dev1adesh/8-bitComputer/8-Bit-Computer_sch.pdf

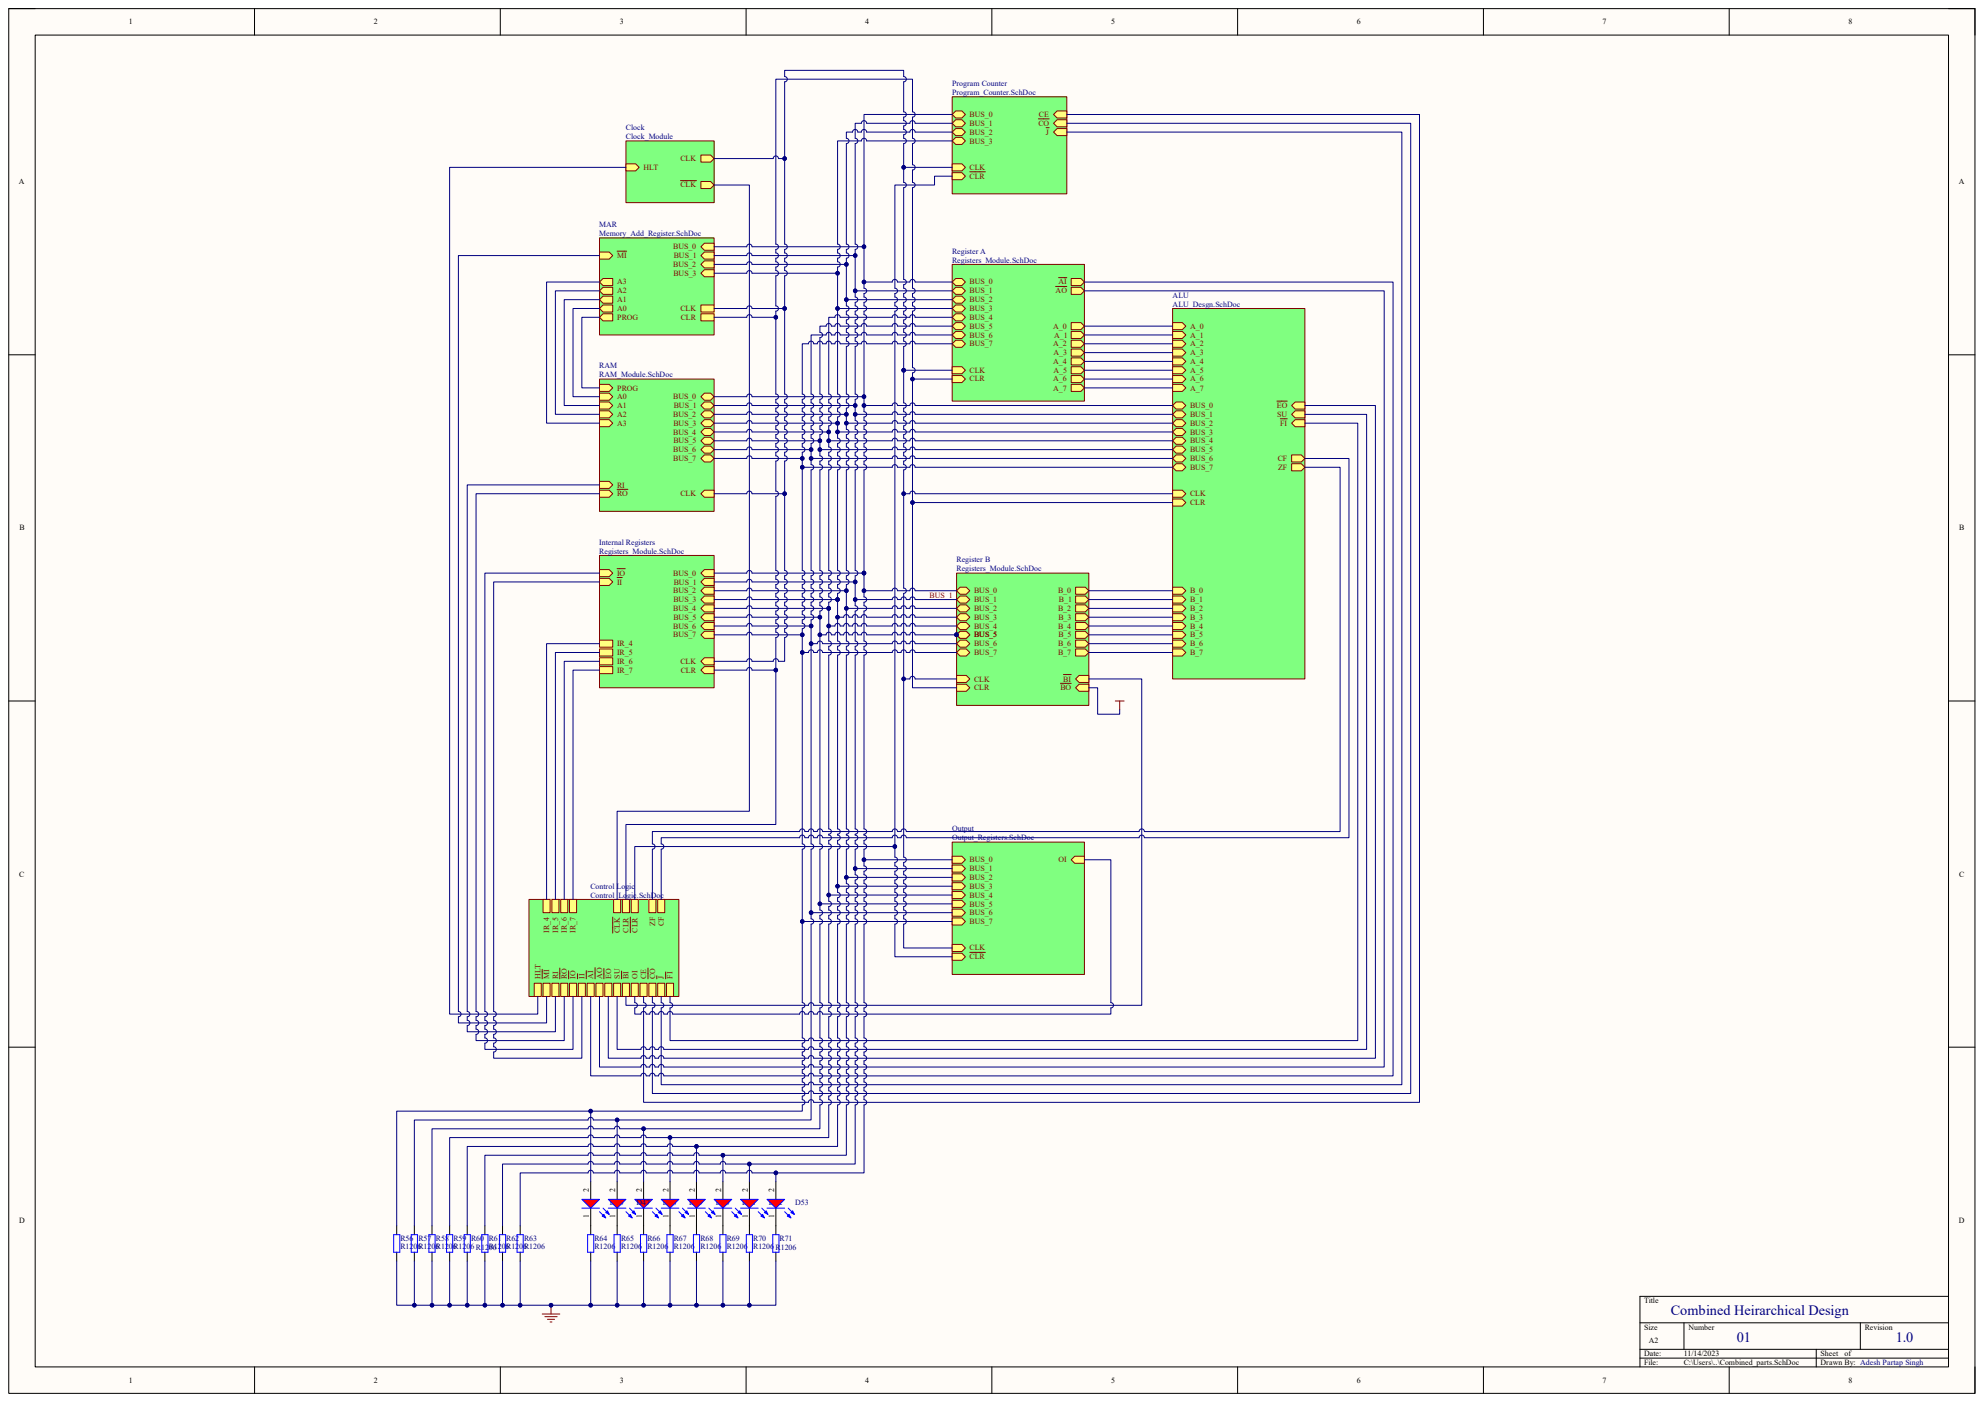
[picture p1: page 1]

Clock
Clock_Module
RAM_Module.SchDoc HLT MI RI ROIOIIAI AOEOSUBI OI CECO

JFI IR_4 IR_5 IR_6 IR_7 CLK CLR CLRZFCF

1

2

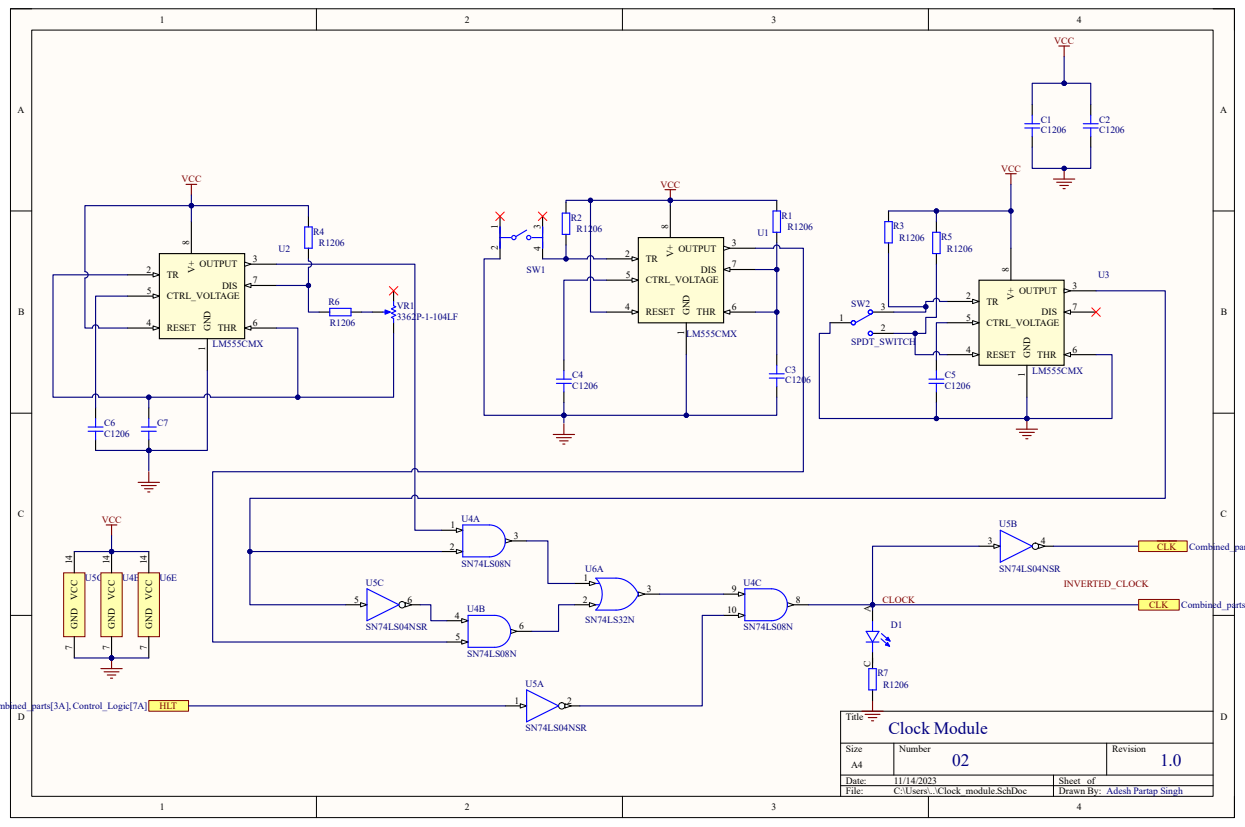
[picture p2: page 2]

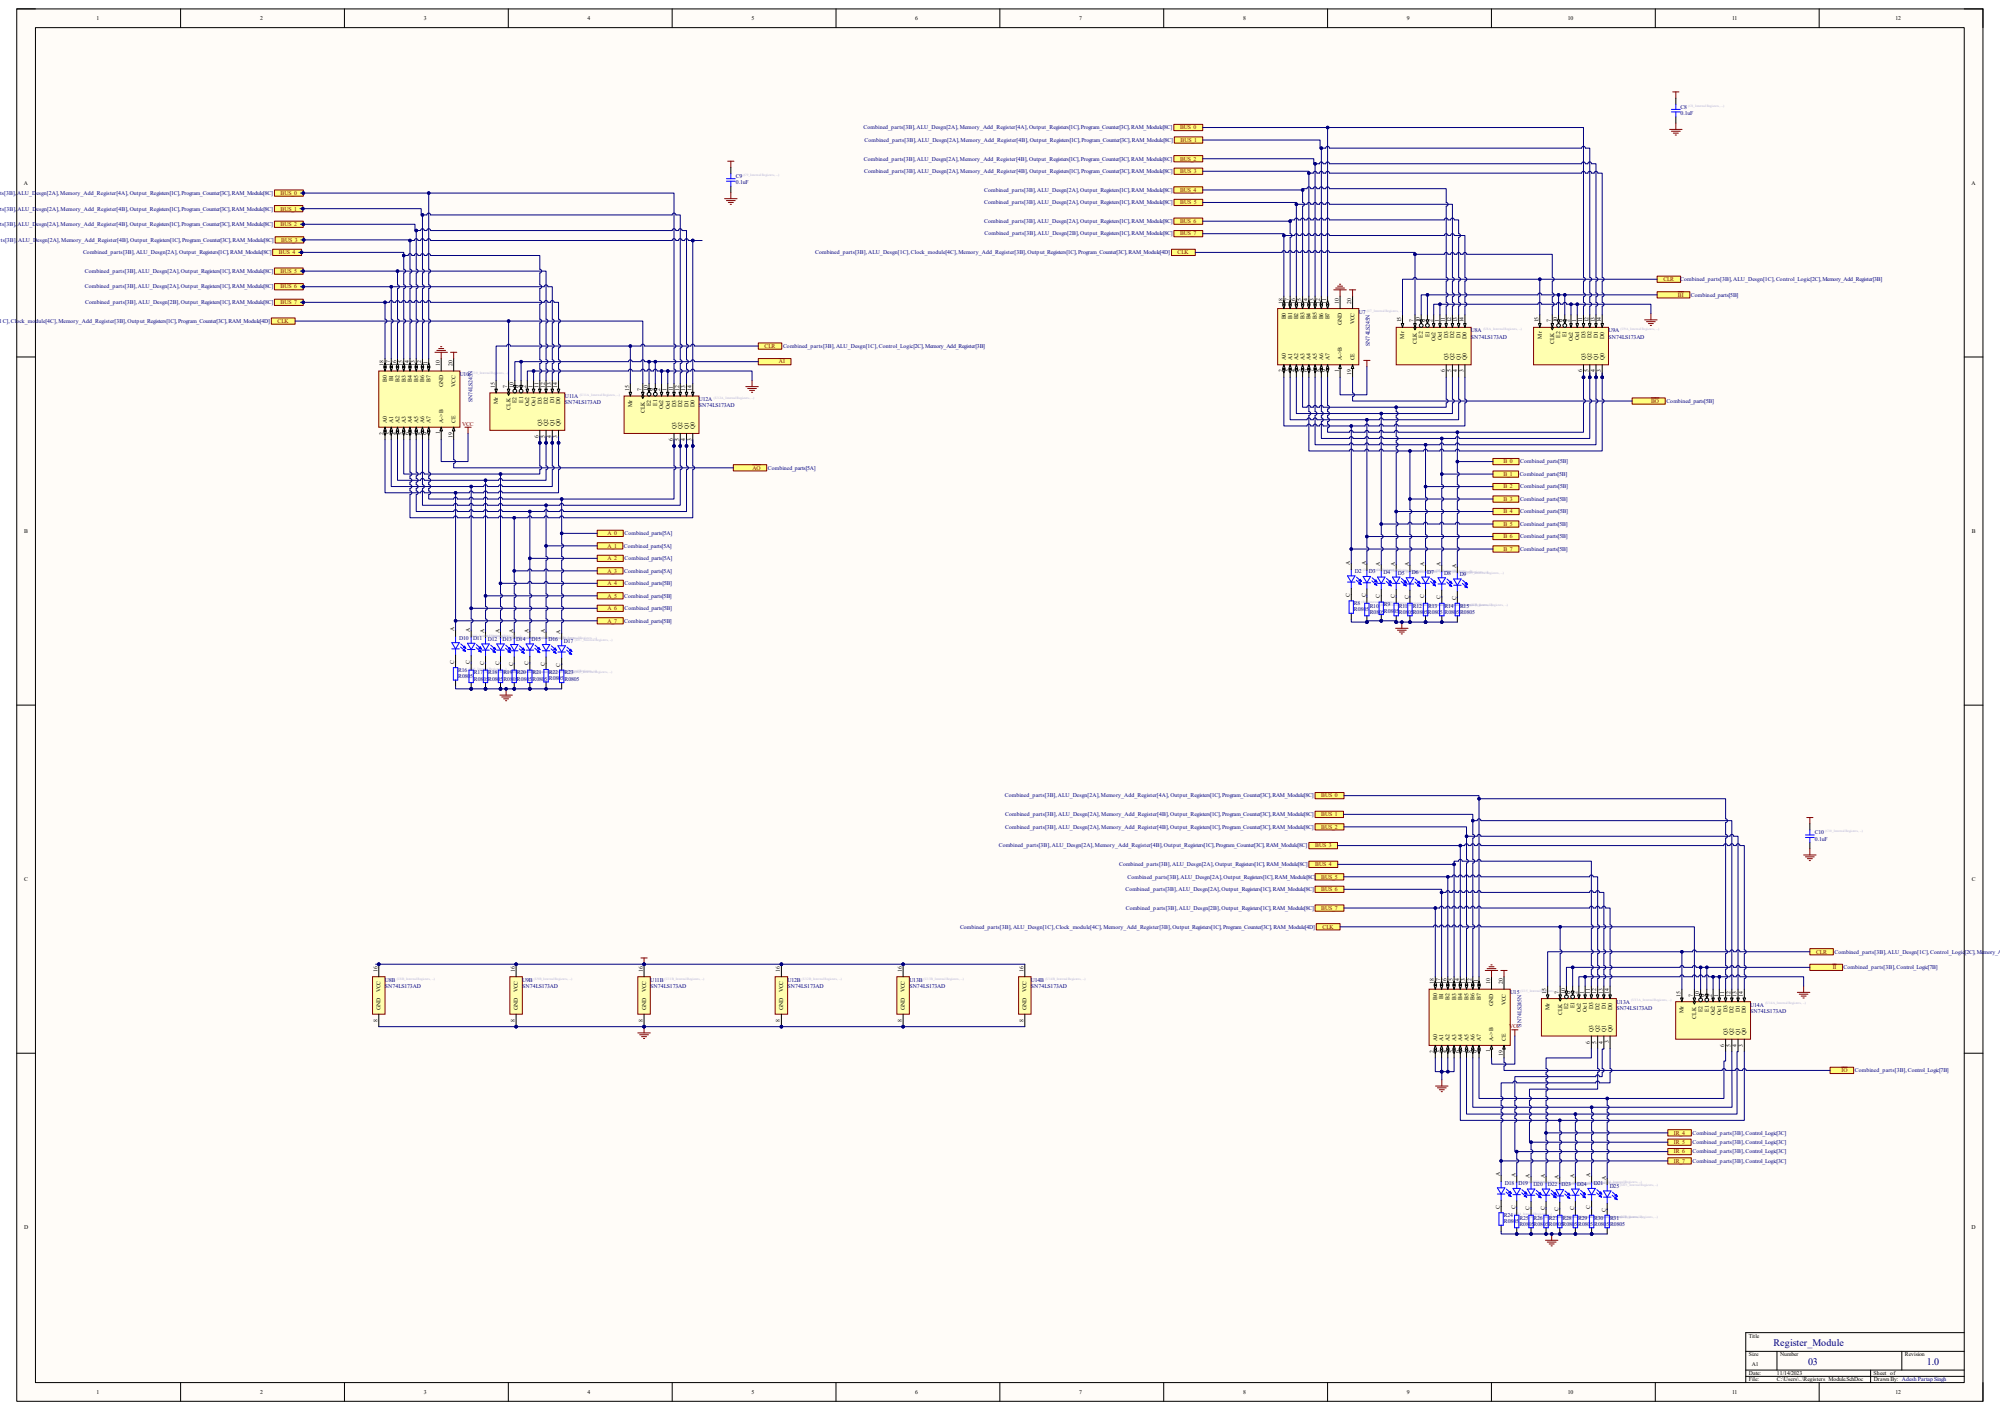
[picture p3: page 3]

BO Combined_parts[5B] A C
B_7 Combined_parts[5B] VCC ²⁰ CE 19 A⁰

VCC VCC ¹⁶ GND

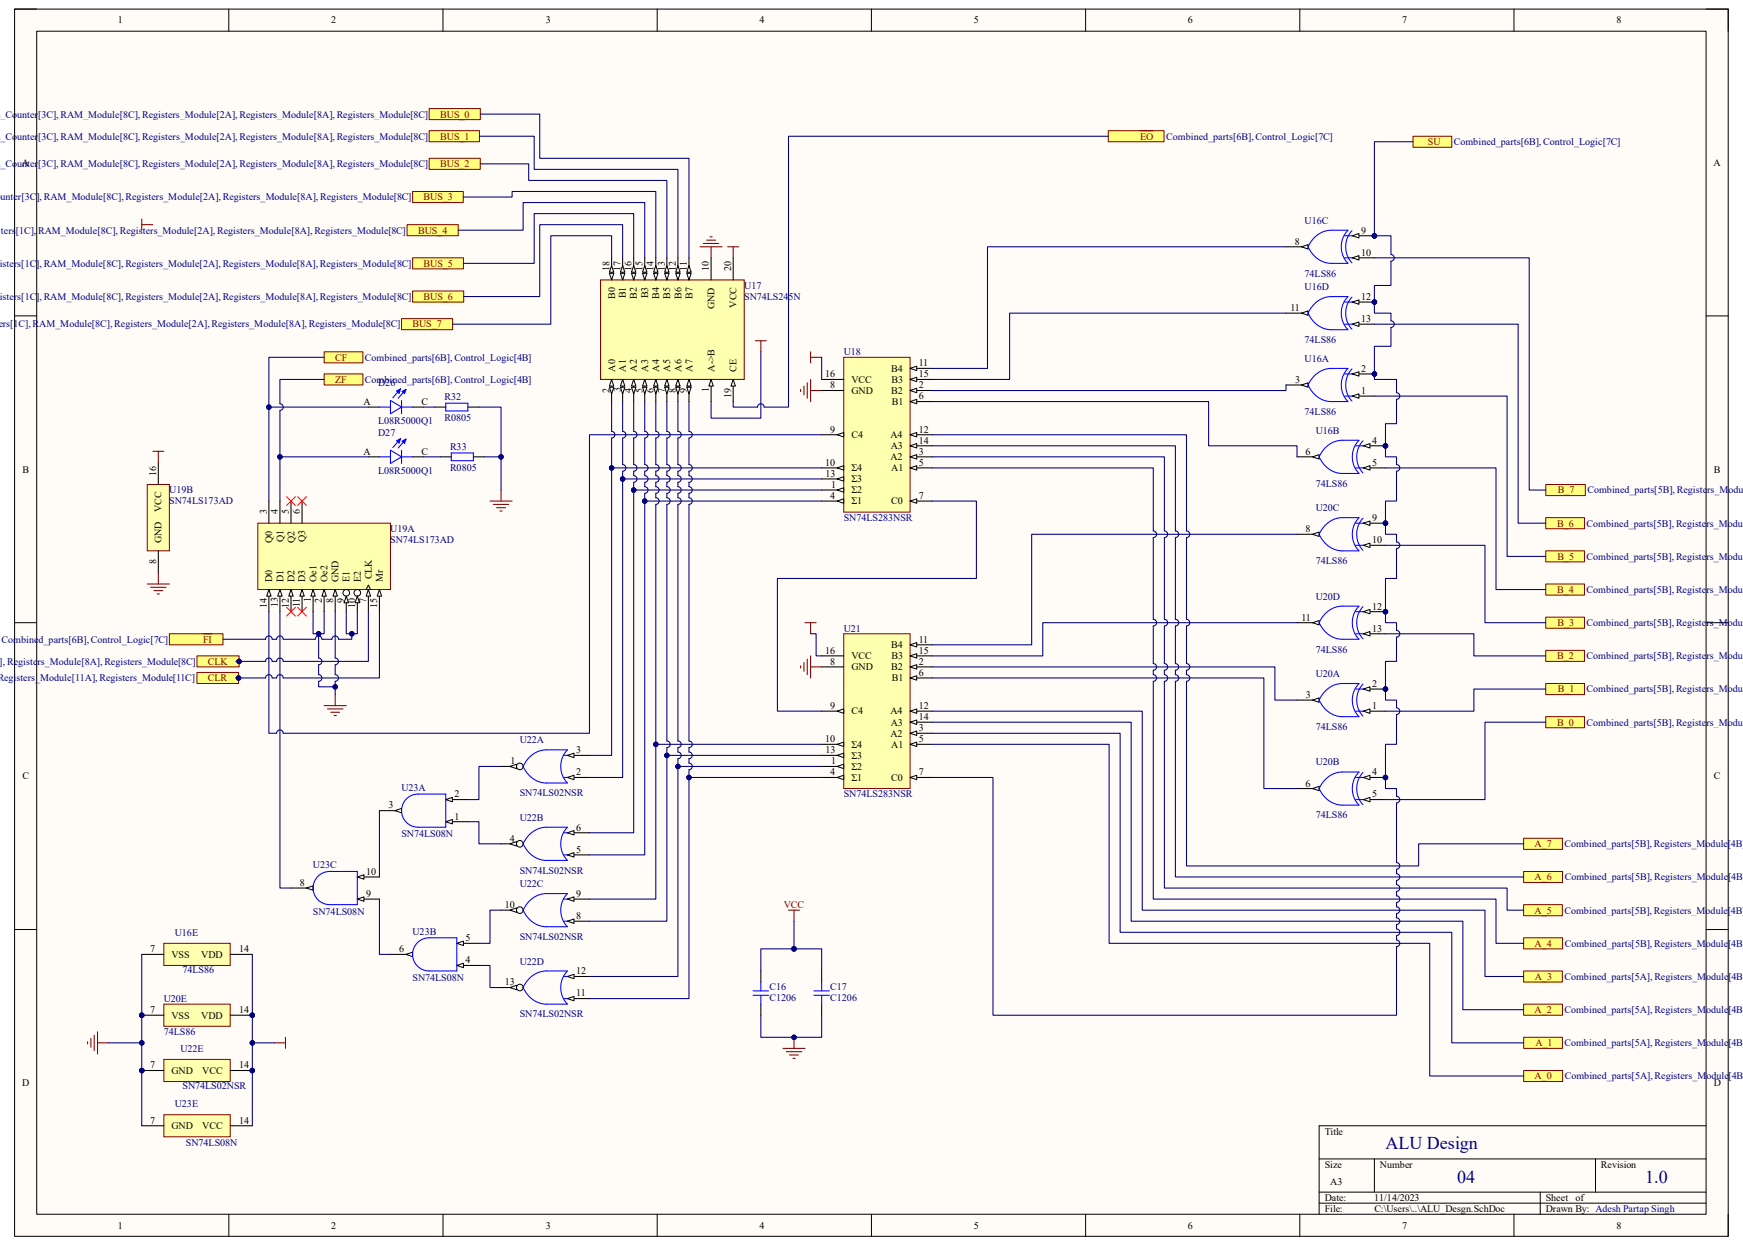
[picture p4: page 4]

SN74LS283NSR VCC ²⁰ CE 19 A⁰

A A

# D28 A C

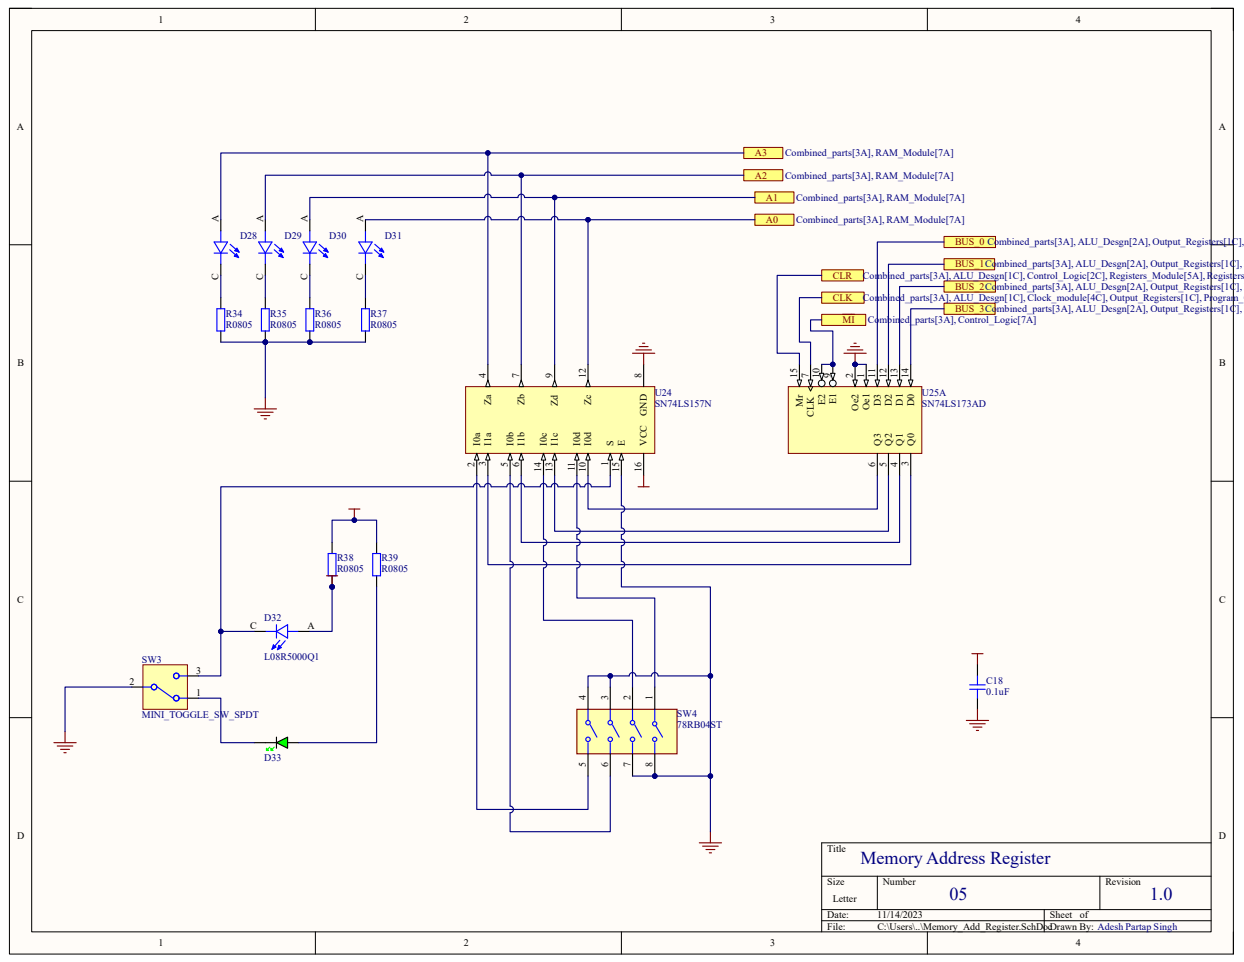
[picture p5: page 5]

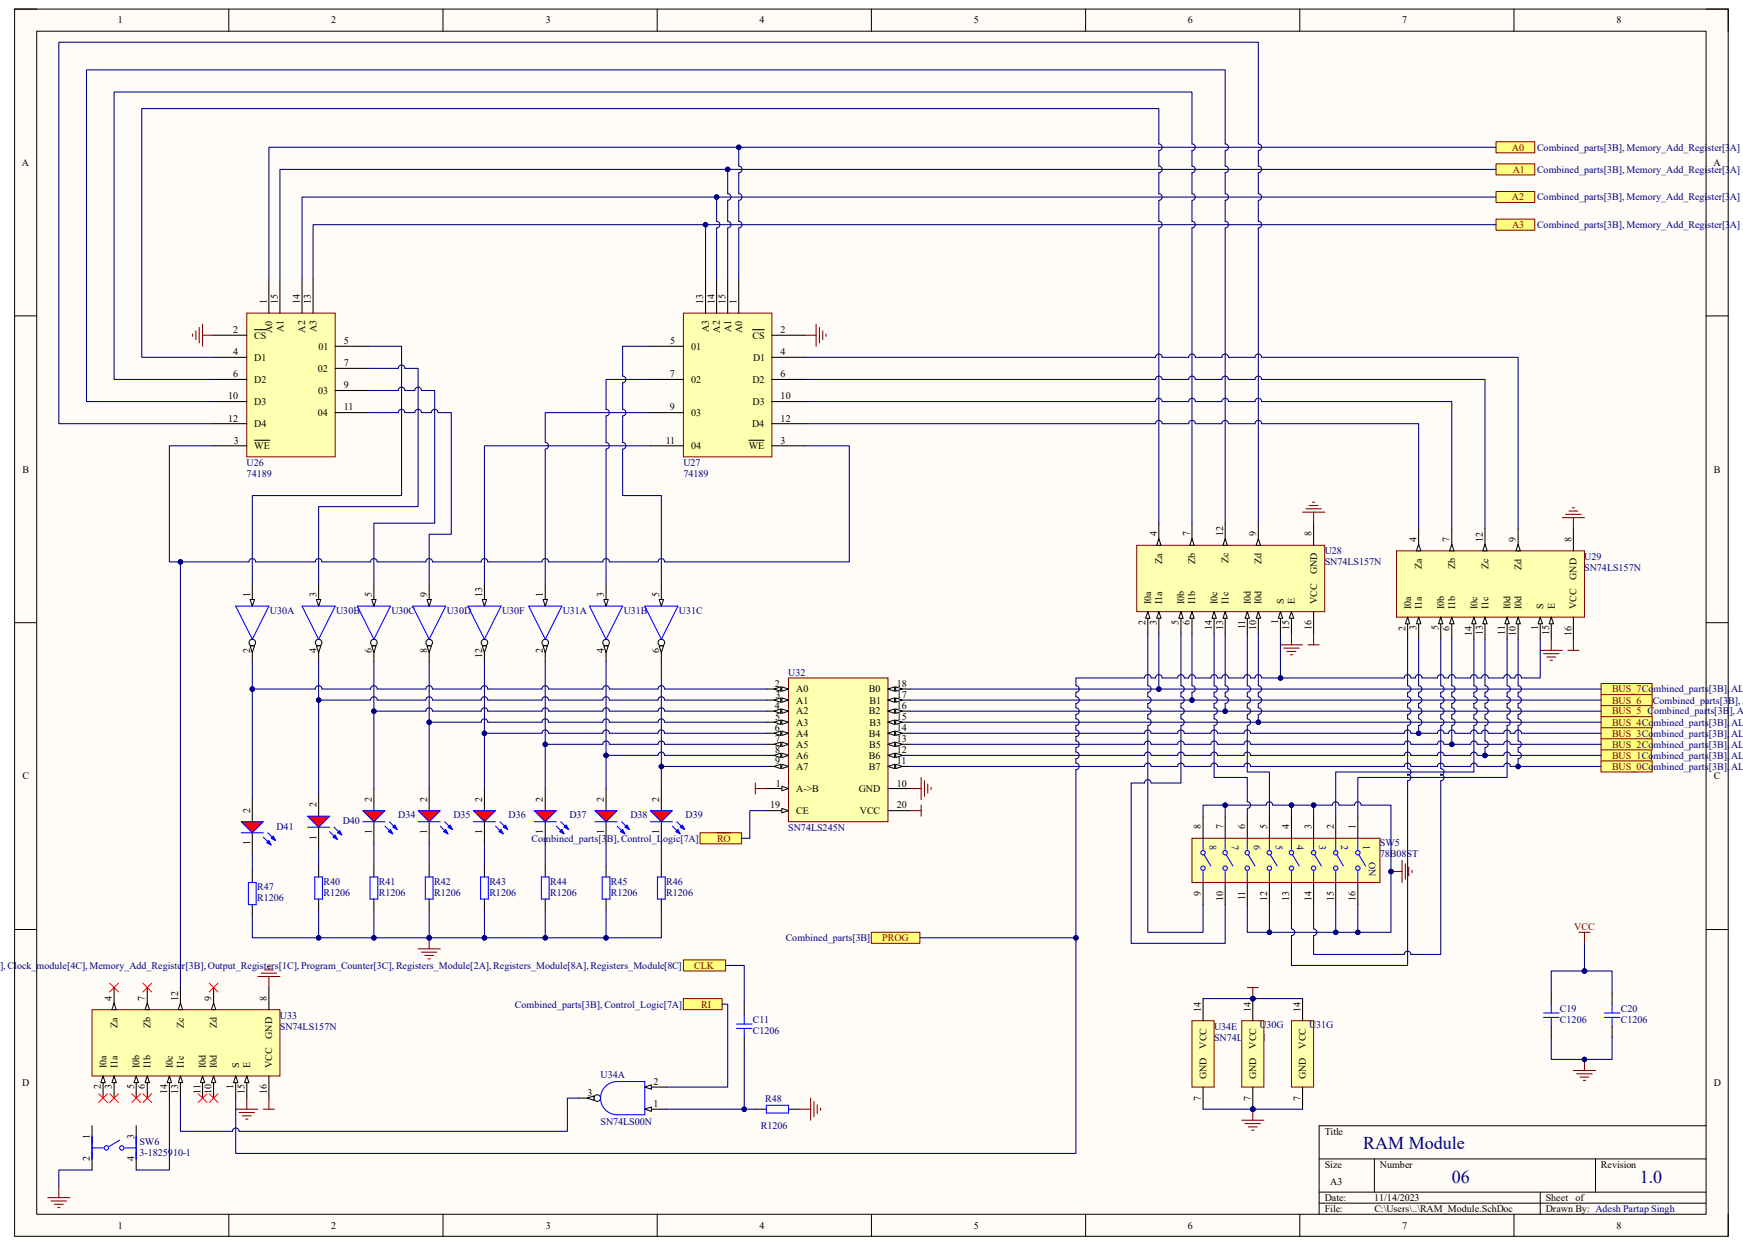
[picture p6: page 6]

A A

C21

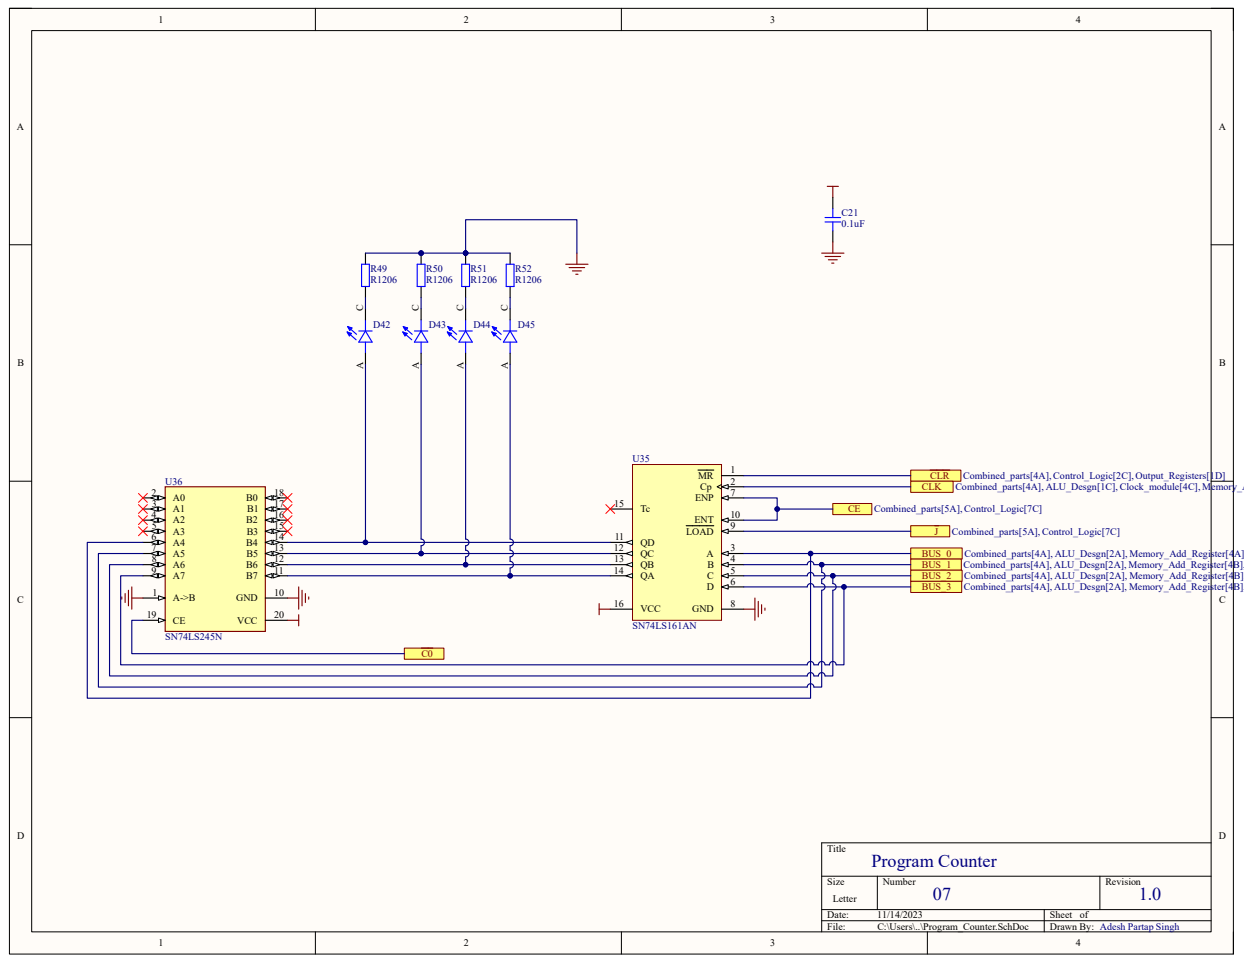
[picture p7: page 7]

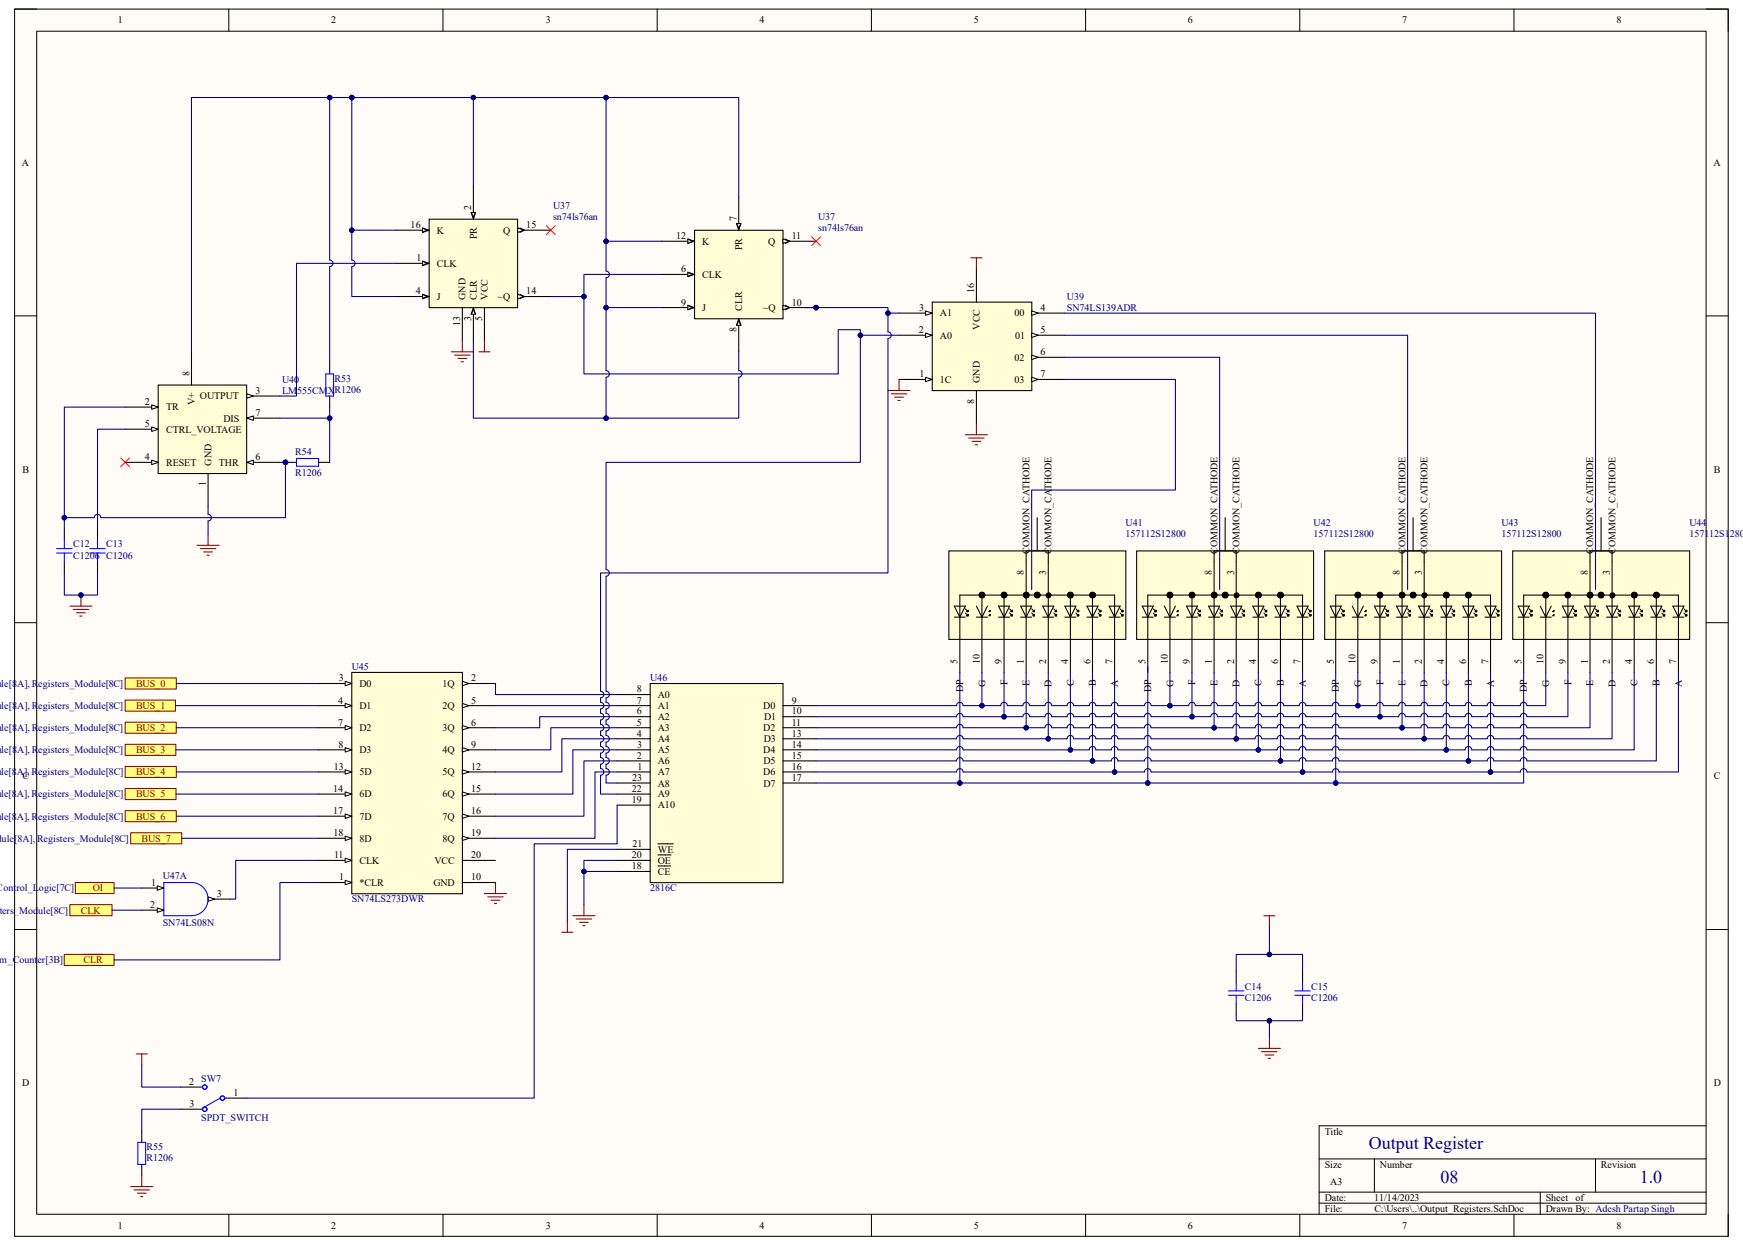
[picture p8: page 8]

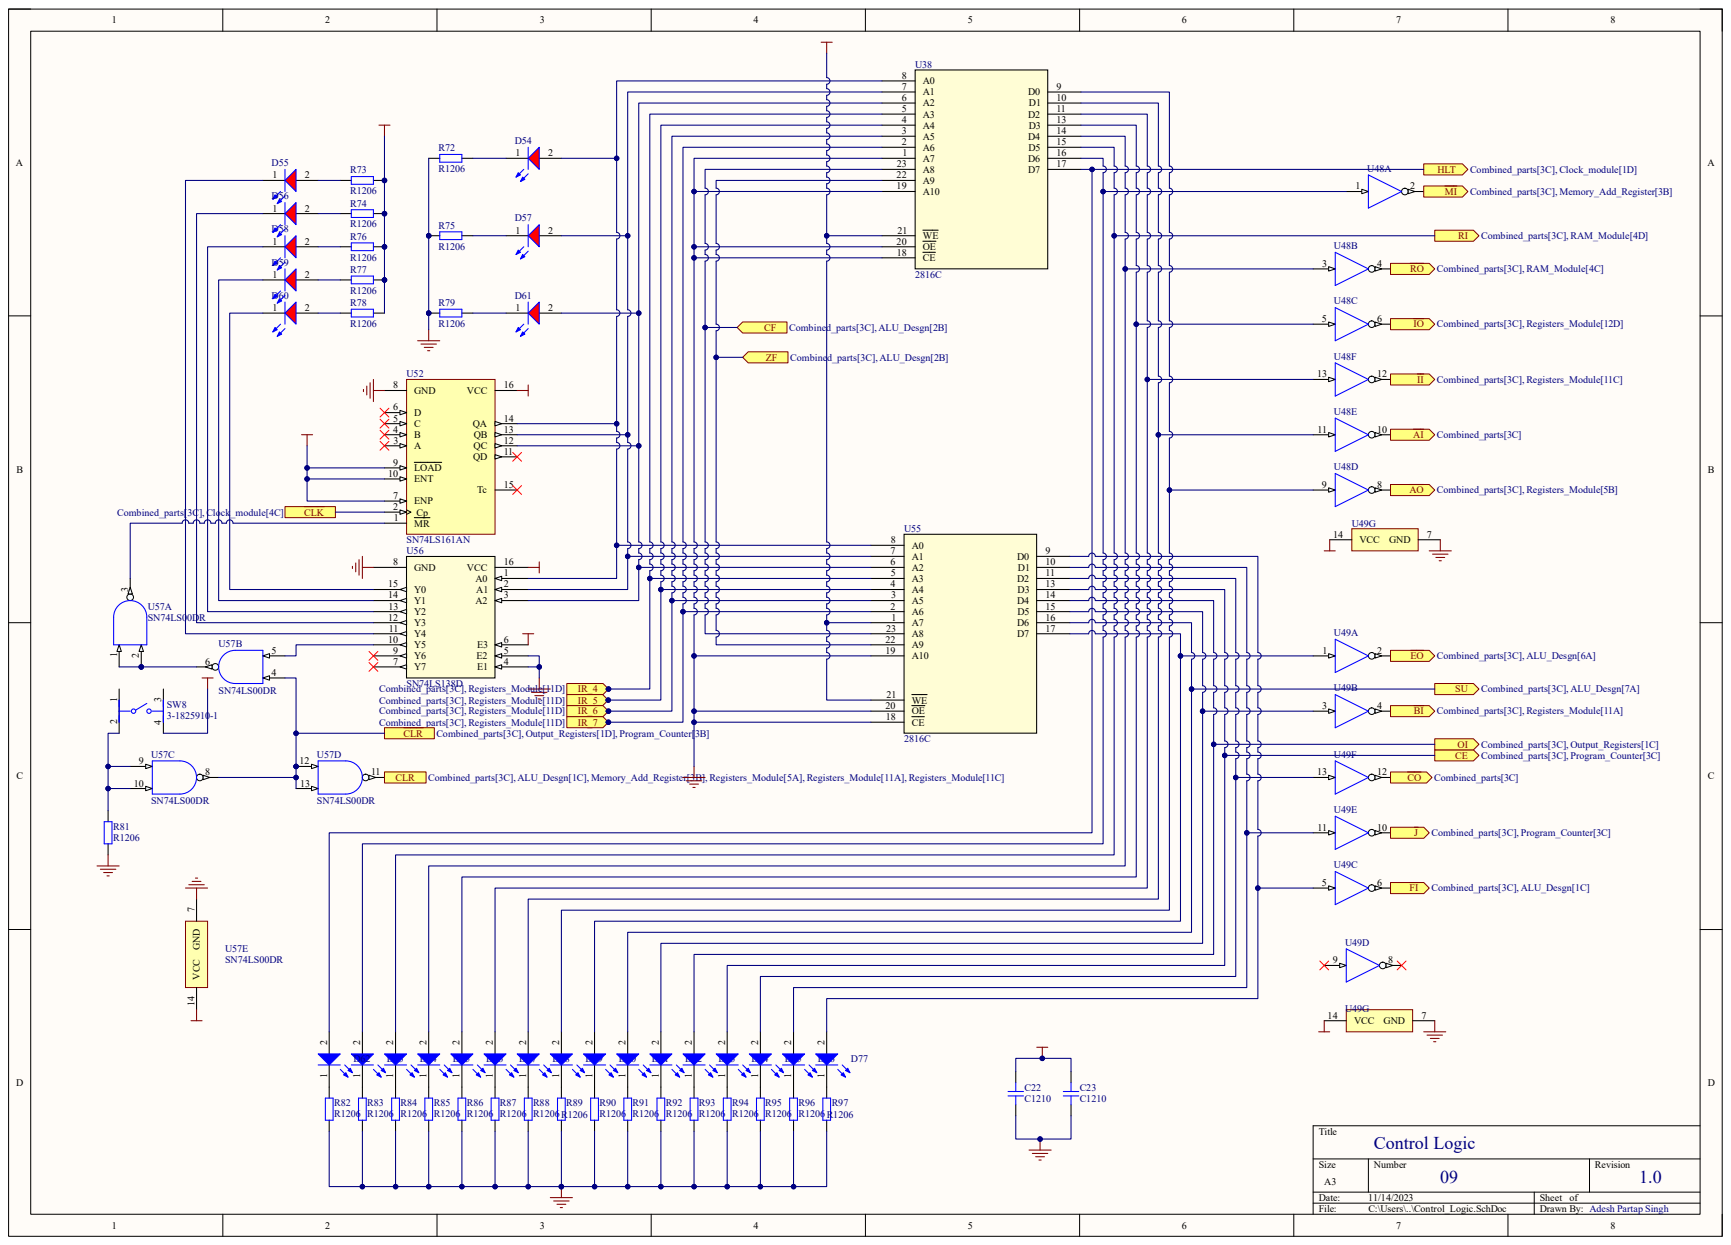
[picture p9: page 9]
