dev1adesh/8-bitComputer/(list of files, drawings)

Other design files:
ALU_Desgn.SchDoc
Clock_module.SchDoc
Combined_parts.SchDoc
Control_Logic.SchDoc
Memory_Add_Register.SchDoc
Output_Registers.SchDoc
Program_Counter.SchDoc
RAM_Module.SchDoc
Registers_Module.SchDoc
