dev1adesh/8-bitComputer/8bit-computer.kicad_pcb

## KiCad design 8bit-computer.kicad_pcb (2023-11-14)

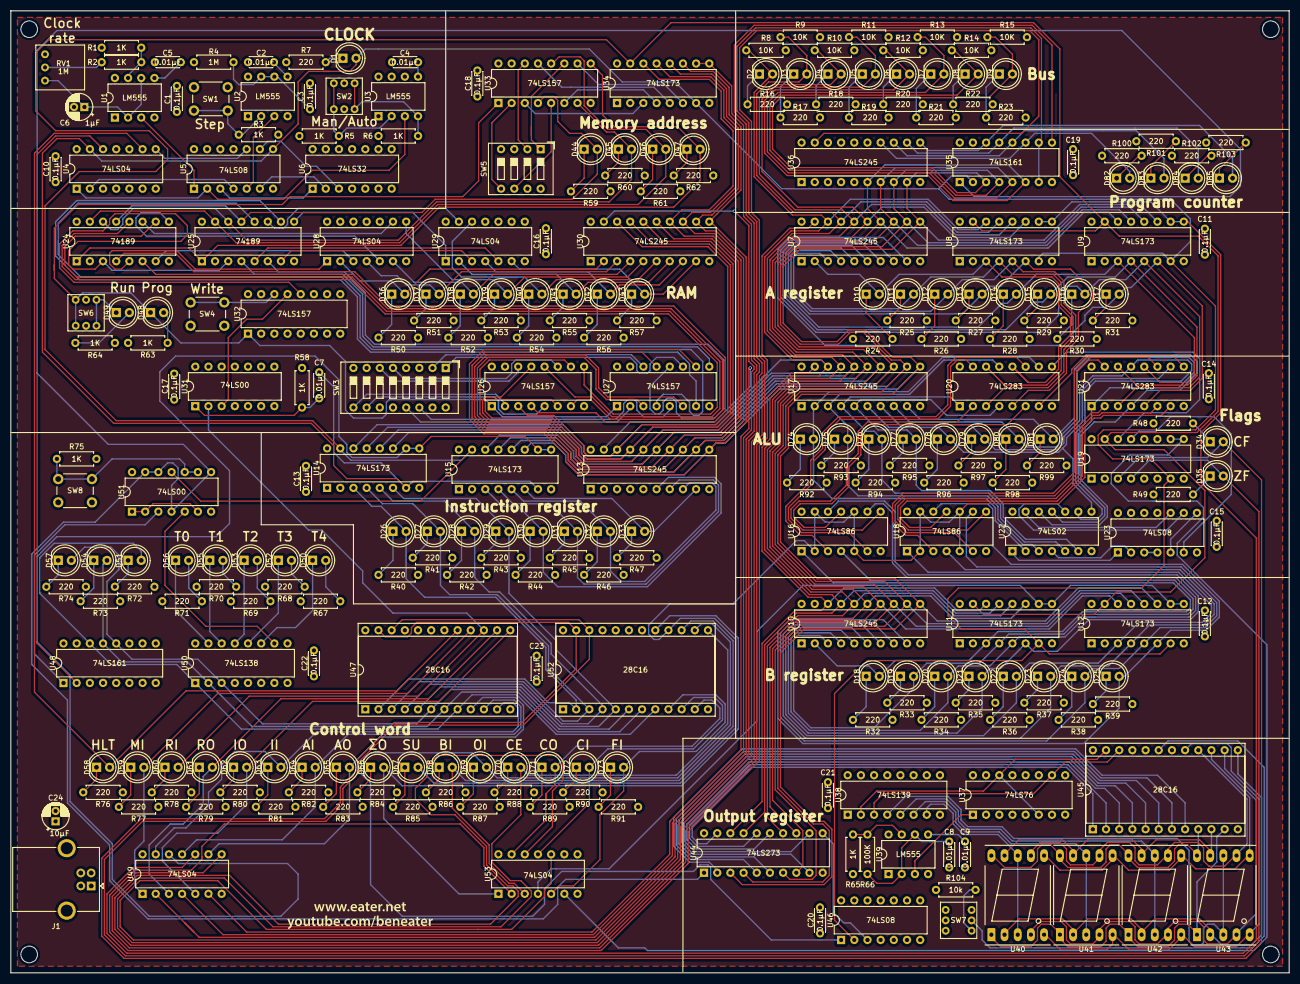
[picture p10: board 8bit-computer.kicad_pcb from above]

Board: 4 copper layers, 246.4 x 185.4 mm, 277 parts (0 on the bottom side), 290 nets.

Parts:
C1, C3, C10, C11, C12, C13, C14, C15, C16, C17, C18, C19, C20, C21, C22, C23: 0.1µF; C_Disc_D4.3mm_W1.9mm_P5.00mm
C2, C4, C5, C7, C8, C9: 0.01µF; C_Disc_D4.3mm_W1.9mm_P5.00mm
C6: 1µF; CP_Radial_D5.0mm_P2.00mm
C24: 10µF; CP_Radial_D5.0mm_P2.00mm
D1, D26, D27, D28, D29, D58, D59, D60, D61, D62, D63, D64, D65, D66, D67, D68, D69, D70, D71, D72, D73: BLUE; LED_D5.0mm
D2, D3, D4, D5, D6, D7, D8, D9, D10, D11, D12, D13, D14, D15, D16, D17, D18, D19, D20, D21, D22, D23, D24, D25, D36, D37, D38, D39, D40, D41, D42, D43, D48, D51, D54, D57, D74, D75, D76, D77, D78, D79, D80, D81: RED; LED_D5.0mm
D30, D31, D32, D33, D44, D45, D46, D47: YELLOW; LED_D5.0mm
D34, D35, D49, D50, D52, D53, D55, D56, D82, D83, D84, D85: GREEN; LED_D5.0mm
J1: USB_B; USB_B_OST_USB-B1HSxx_Horizontal
R1, R2, R3, R5, R6, R58, R63, R64, R65, R75: 1K; R_Axial_DIN0207_L6.3mm_D2.5mm_P7.62mm_Horizontal
R4: 1M; R_Axial_DIN0207_L6.3mm_D2.5mm_P7.62mm_Horizontal
R7, R16, R17, R18, R19, R20, R21, R22, R23, R24, R25, R26, R27, R28, R29, R30, R31, R32, R33, R34, R35, R36, R37, R38, R39, R40, R41, R42, R43, R44, R45, R46, R47, R48, R49, R50, R51, R52, R53, R54, R55, R56, R57, R59, R60, R61, R62, R67, R68, R69, R70, R71, R72, R73, R74, R76, R77, R78, R79, R80, R81, R82, R83, R84, R85, R86, R87, R88, R89, R90, R91, R92, R93, R94, R95, R96, R97, R98, R99, R100, R101, R102, R103: 220; R_Axial_DIN0207_L6.3mm_D2.5mm_P7.62mm_Horizontal
R8, R9, R10, R11, R12, R13, R14, R15: 10K; R_Axial_DIN0207_L6.3mm_D2.5mm_P7.62mm_Horizontal
R66: 100K; R_Axial_DIN0207_L6.3mm_D2.5mm_P7.62mm_Horizontal
R104: 10k; R_Axial_DIN0207_L6.3mm_D2.5mm_P7.62mm_Horizontal
RV1: 1M; Potentiometer-5.5mm
SW1, SW4: SW_Push; SW_PUSH_6mm_H5mm
SW2, SW6, SW7: SW_SPDT; DPDT-pushbutton
SW3: SW_DIP_x08; SW_DIP_SPSTx08_Slide_9.78x22.5mm_W7.62mm_P2.54mm
SW5: SW_DIP_x04; SW_DIP_SPSTx04_Slide_9.78x12.34mm_W7.62mm_P2.54mm
SW8: Reset; SW_PUSH_6mm_H5mm
U1, U2, U3, U39: LM555; DIP-8_W7.62mm
U4, U28, U29, U49, U53: 74LS04; DIP-14_W7.62mm
U5, U23, U46: 74LS08; DIP-14_W7.62mm
U6: 74LS32; DIP-14_W7.62mm
U7, U10, U13, U17, U30, U36: 74LS245; DIP-20_W7.62mm
U8, U9, U11, U12, U14, U15, U19, U34: 74LS173; DIP-16_W7.62mm
U16, U18: 74LS86; DIP-14_W7.62mm
U20, U21: 74LS283; DIP-16_W7.62mm
U22: 74LS02; DIP-14_W7.62mm
U24, U25: 74189; DIP-16_W7.62mm
U26, U27, U32, U33: 74LS157; DIP-16_W7.62mm
U31, U51: 74LS00; DIP-14_W7.62mm
U35, U48: 74LS161; DIP-16_W7.62mm
U37: 74LS76; DIP-16_W7.62mm
U38: 74LS139; DIP-16_W7.62mm
U40, U41, U42, U43: 7SEGMENT_CC; 7SegmentLED_LTS6760_LTS6780
U44: 74LS273; DIP-20_W7.62mm
U45, U47, U52: 28C16; DIP-24_W15.24mm_Socket
U50: 74LS138; DIP-16_W7.62mm
svg2mod: G***; BenEater

Connections:
/A register/A_0: D17.2, U7.9, U9.6, U21.5
/A register/A_1: D16.2, U7.8, U9.5, U21.3
/A register/A_2: D15.2, U7.7, U9.4, U21.14
/A register/A_3: D14.2, U7.6, U9.3, U21.12
/A register/A_4: D13.2, U7.5, U8.6, U20.5
/A register/A_5: D12.2, U7.4, U8.5, U20.3
/A register/A_6: D11.2, U7.3, U8.4, U20.14
/A register/A_7: D10.2, U7.2, U8.3, U20.12
/A register/BUS_0: D9.2, R15.1, U7.11, U9.11, U10.11, U12.11, U13.11, U15.11, U17.11, U27.10, U30.11, U34.11, U35.3, U36.9, U44.3
/A register/BUS_1: D8.2, R14.1, U7.12, U9.12, U10.12, U12.12, U13.12, U15.12, U17.12, U27.13, U30.12, U34.12, U35.4, U36.8, U44.4
/A register/BUS_2: D7.2, R13.1, U7.13, U9.13, U10.13, U12.13, U13.13, U15.13, U17.13, U27.6, U30.13, U34.13, U35.5, U36.7, U44.7
/A register/BUS_3: D6.2, R12.1, U7.14, U9.14, U10.14, U12.14, U13.14, U15.14, U17.14, U27.3, U30.14, U34.14, U35.6, U36.6, U44.8
/A register/BUS_4: D5.2, R11.1, U7.15, U8.11, U10.15, U11.11, U13.15, U14.11, U17.15, U26.10, U30.15, U44.13
/A register/BUS_5: D4.2, R10.1, U7.16, U8.12, U10.16, U11.12, U13.16, U14.12, U17.16, U26.13, U30.16, U44.14
/A register/BUS_6: D3.2, R9.1, U7.17, U8.13, U10.17, U11.13, U13.17, U14.13, U17.17, U26.6, U30.17, U44.17
/A register/BUS_7: D2.2, R8.1, U7.18, U8.14, U10.18, U11.14, U13.18, U14.14, U17.18, U26.3, U30.18, U44.18
/A register/CLK: C7.1, D1.2, U4.13, U5.8, U8.7, U9.7, U11.7, U12.7, U14.7, U15.7, U19.7, U34.7, U35.2, U46.2
/A register/CLR: U8.15, U9.15, U11.15, U12.15, U14.15, U15.15, U19.15, U34.15, U51.11
/A register/~AI: U8.9, U8.10, U9.9, U9.10, U49.10
/A register/~AO: U7.19, U49.8
/ALU/B_0: D25.2, U10.9, U12.6, U18.12
/ALU/B_1: D24.2, U10.8, U12.5, U18.9
/ALU/B_2: D23.2, U10.7, U12.4, U18.4
/ALU/B_3: D22.2, U10.6, U12.3, U18.1
/ALU/B_4: D21.2, U10.5, U11.6, U16.12
/ALU/B_5: D20.2, U10.4, U11.5, U16.9
/ALU/B_6: D19.2, U10.3, U11.4, U16.4
/ALU/B_7: D18.2, U10.2, U11.3, U16.1
/ALU/CF: D34.2, U19.3, U47.23, U52.23
/ALU/SU: D67.2, U16.2, U16.5, U16.10, U16.13, U18.2, U18.5, U18.10, U18.13, U21.7, U52.16
/ALU/ZF: D35.2, U19.4, U47.22, U52.22
/ALU/~EO: U17.19, U53.2
/ALU/~FI: U19.9, U19.10, U53.6
/B register/~BI: U11.9, U11.10, U12.9, U12.10, U53.4
/Clock/HLT: D58.2, U4.9, U47.17
/Clock/~CLK: U4.12, U48.2
/Control logic/CE: D70.2, U35.7, U35.10, U52.13
/Control logic/IR_4: D29.2, U14.6, U47.5, U52.5
/Control logic/IR_5: D28.2, U14.5, U47.4, U52.4
/Control logic/IR_6: D27.2, U14.4, U47.3, U52.3
/Control logic/IR_7: D26.2, U14.3, U47.2, U52.2
/Control logic/OI: D69.2, U46.1, U52.14
/Control logic/RI: D60.2, U31.2, U47.15
/Control logic/~CLR: U35.1, U44.1, U51.4, U51.8, U51.12, U51.13
/Control logic/~CO: U36.19, U53.12
/Control logic/~II: U14.9, U14.10, U15.9, U15.10, U49.12
/Control logic/~IO: U13.19, U49.6
/Control logic/~J: U35.9, U53.10
/Control logic/~MI: U34.9, U34.10, U49.2
/Control logic/~RO: U30.19, U49.4
/MAR/A0: D47.2, U24.1, U25.1, U33.9
/MAR/A1: D46.2, U24.15, U25.15, U33.12
/MAR/A2: D45.2, U24.14, U25.14, U33.7
/MAR/A3: D44.2, U24.13, U25.13, U33.4
/MAR/PROG: D48.1, SW6.1, U26.1, U27.1, U32.1, U33.1
GND: C1.2, C2.2, C3.2, C4.2, C5.2, C6.2, C8.2, C9.2, C10.2, C11.2, C12.2, C13.2, C14.2, C15.2, C16.2, C17.2, C18.2, C19.2, C20.2, C21.2, C22.2, C23.2, C24.2, J1.4, J1.5, R7.2, R8.2, R9.2, R10.2, R11.2, R12.2, R13.2, R14.2, R15.2, R16.2, R17.2, R18.2, R19.2, R20.2, R21.2, R22.2, R23.2, R24.2, R25.2, R26.2, R27.2, R28.2, R29.2, R30.2, R31.2, R32.2, R33.2, R34.2, R35.2, R36.2, R37.2, R38.2, R39.2, R40.2, R41.2, R42.2, R43.2, R44.2, R45.2, R46.2, R47.2, R48.1, R49.1, R50.2, R51.2, R52.2, R53.2, R54.2, R55.2, R56.2, R57.2, R58.1, R59.2, R60.2, R61.2, R62.2, R72.2, R73.2, R74.2, R75.2, R76.2, R77.2, R78.2, R79.2, R80.2, R81.2, R82.2, R83.2, R84.2, R85.2, R86.2, R87.2, R88.2, R89.2, R90.2, R91.2, R92.2, R93.2, R94.2, R95.2, R96.2, R97.2, R98.2, R99.2, R100.1, R101.1, R102.1, R103.1, R104.2, SW1.1, SW2.2, SW3.3, SW3.4, SW3.7, SW3.8, SW3.11, SW3.12, SW3.15, SW3.16, SW4.1, SW5.3, SW5.4, SW5.7, SW5.8, SW6.2, U1.1, U2.1, U3.1, U3.6, U4.7, U5.7, U6.7, U7.10, U8.1, U8.2, U8.8, U9.1, U9.2, U9.8, U10.10, U11.1, U11.2, U11.8, U12.1, U12.2, U12.8, U13.2, U13.3, U13.4, U13.5, U13.10, U14.1, U14.2, U14.8, U15.1, U15.2, U15.8, U16.7, U17.10, U18.7, U19.1, U19.2, U19.8, U20.8, U21.8, U22.7, U23.7, U24.2, U24.8, U25.2, U25.8, U26.8, U26.15, U27.8, U27.15, U28.7, U29.7, U30.10, U31.7, U32.8, U32.15, U33.8, U33.15, U34.1, U34.2, U34.8, U35.8, U36.1, U36.10, U37.13, U38.1, U38.8, U39.1, U44.10, U45.12, U45.18, U45.20, U46.7, U47.1, U47.12, U47.18, U47.19, U47.20, U48.8, U49.7, U50.4, U50.5, U50.8, U51.7, U52.12, U52.18, U52.19, U52.20, U53.7
unnamed: C2.1, U2.5
unnamed: C3.1, R4.2, U2.6, U2.7
unnamed: C4.1, U3.5
unnamed: C5.1, U1.5
unnamed: C6.1, RV1.1, U1.2, U1.6
unnamed: C7.2, R58.2, U31.1
unnamed: C8.1, R66.2, U39.2, U39.6
unnamed: C9.1, U39.5
unnamed: D1.1, R7.1
unnamed: D2.1, R16.1
unnamed: D3.1, R17.1
unnamed: D4.1, R18.1
unnamed: D5.1, R19.1
unnamed: D6.1, R20.1
unnamed: D7.1, R21.1
unnamed: D8.1, R22.1
unnamed: D9.1, R23.1
unnamed: D10.1, R24.1
unnamed: D11.1, R25.1
unnamed: D12.1, R26.1
unnamed: D13.1, R27.1
unnamed: D14.1, R28.1
unnamed: D15.1, R29.1
unnamed: D16.1, R30.1
unnamed: D17.1, R31.1
unnamed: D18.1, R32.1
unnamed: D19.1, R33.1
unnamed: D20.1, R34.1
unnamed: D21.1, R35.1
unnamed: D22.1, R36.1
unnamed: D23.1, R37.1
unnamed: D24.1, R38.1
unnamed: D25.1, R39.1
unnamed: D26.1, R40.1
unnamed: D27.1, R41.1
unnamed: D28.1, R42.1
unnamed: D29.1, R43.1
unnamed: D30.1, R44.1
unnamed: D30.2, U13.6, U15.3
unnamed: D31.1, R45.1
unnamed: D31.2, U13.7, U15.4
unnamed: D32.1, R46.1
unnamed: D32.2, U13.8, U15.5
unnamed: D33.1, R47.1
unnamed: D33.2, U13.9, U15.6
unnamed: D34.1, R48.2
unnamed: D35.1, R49.2
unnamed: D36.1, R50.1
unnamed: D36.2, U28.2, U30.2
unnamed: D37.1, R51.1
unnamed: D37.2, U28.4, U30.3
unnamed: D38.1, R52.1
unnamed: D38.2, U28.6, U30.4
unnamed: D39.1, R53.1
unnamed: D39.2, U28.8, U30.5
unnamed: D40.1, R54.1
unnamed: D40.2, U29.12, U30.6
unnamed: D41.1, R55.1
unnamed: D41.2, U29.2, U30.7
unnamed: D42.1, R56.1
unnamed: D42.2, U29.4, U30.8
unnamed: D43.1, R57.1
unnamed: D43.2, U29.6, U30.9
unnamed: D44.1, R59.1
unnamed: D45.1, R60.1
unnamed: D46.1, R61.1
unnamed: D47.1, R62.1
unnamed: D48.2, R63.2
unnamed: D49.1, SW6.3
unnamed: D49.2, R64.2
unnamed: D50.1, U50.11
unnamed: D50.2, R67.2
unnamed: D51.1, R72.1
unnamed: D51.2, U47.8, U48.14, U50.1, U52.8
unnamed: D52.1, U50.12
unnamed: D52.2, R68.2
unnamed: D53.1, U50.13
unnamed: D53.2, R69.2
unnamed: D54.1, R73.1
unnamed: D54.2, U47.7, U48.13, U50.2, U52.7
unnamed: D55.1, U50.14
unnamed: D55.2, R70.2
unnamed: D56.1, U50.15
unnamed: D56.2, R71.2
unnamed: D57.1, R74.1
unnamed: D57.2, U47.6, U48.12, U50.3, U52.6
unnamed: D58.1, R76.1
unnamed: D59.1, R77.1
unnamed: D59.2, U47.16, U49.1
unnamed: D60.1, R78.1
unnamed: D61.1, R79.1
unnamed: D61.2, U47.14, U49.3
unnamed: D62.1, R80.1
unnamed: D62.2, U47.13, U49.5
unnamed: D63.1, R81.1
unnamed: D63.2, U47.11, U49.13
unnamed: D64.1, R82.1
unnamed: D64.2, U47.10, U49.11
unnamed: D65.1, R83.1
unnamed: D65.2, U47.9, U49.9
unnamed: D66.1, R84.1
unnamed: D66.2, U52.17, U53.1
unnamed: D67.1, R85.1
unnamed: D68.1, R86.1
unnamed: D68.2, U52.15, U53.3
unnamed: D69.1, R87.1
unnamed: D70.1, R88.1
unnamed: D71.1, R89.1
unnamed: D71.2, U52.11, U53.13
unnamed: D72.1, R90.1
unnamed: D72.2, U52.10, U53.11
unnamed: D73.1, R91.1
unnamed: D73.2, U52.9, U53.5
unnamed: D74.1, R92.1
unnamed: D74.2, U17.2, U20.10, U22.2
unnamed: D75.1, R93.1
unnamed: D75.2, U17.3, U20.13, U22.3
unnamed: D76.1, R94.1
unnamed: D76.2, U17.4, U20.1, U22.5
unnamed: D77.1, R95.1
unnamed: D77.2, U17.5, U20.4, U22.6
unnamed: D78.1, R96.1
unnamed: D78.2, U17.6, U21.10, U22.8
unnamed: D79.1, R97.1
unnamed: D79.2, U17.7, U21.13, U22.9
unnamed: D80.1, R98.1
unnamed: D80.2, U17.8, U21.1, U22.11
unnamed: D81.1, R99.1
unnamed: D81.2, U17.9, U21.4, U22.12
unnamed: D82.1, R100.2
unnamed: D82.2, U35.11, U36.14
unnamed: D83.1, R101.2
unnamed: D83.2, U35.12, U36.13
unnamed: D84.1, R102.2
unnamed: D84.2, U35.13, U36.12
unnamed: D85.1, R103.2
unnamed: D85.2, U35.14, U36.11
unnamed: R1.2, R2.2, U1.7
unnamed: R2.1, RV1.2
unnamed: R3.2, SW1.2, U2.2
unnamed: R5.2, SW2.1, U3.2
unnamed: R6.2, SW2.3, U3.4
unnamed: R65.2, R66.1, U39.7
unnamed: R75.1, SW8.1, U51.9, U51.10
unnamed: R104.1, SW7.1
unnamed: SW3.1, U27.11
unnamed: SW3.2, U27.14
unnamed: SW3.5, U26.11
unnamed: SW3.6, U26.14
unnamed: SW3.9, U26.2
unnamed: SW3.10, U26.5
unnamed: SW3.13, U27.2
unnamed: SW3.14, U27.5
unnamed: SW4.2, U32.14
unnamed: SW5.1, U33.11
unnamed: SW5.2, U33.14
unnamed: SW5.5, U33.2
unnamed: SW5.6, U33.5
unnamed: SW7.2, U45.19
unnamed: U1.3, U5.1
unnamed: U2.3, U5.5
unnamed: U3.3, U4.1, U5.2
unnamed: U4.2, U5.4
unnamed: U4.8, U5.10
unnamed: U5.3, U6.1
unnamed: U5.6, U6.2
unnamed: U5.9, U6.3
unnamed: U16.3, U20.11
unnamed: U16.6, U20.15
unnamed: U16.8, U20.2
unnamed: U16.11, U20.6
unnamed: U18.3, U21.11
unnamed: U18.6, U21.15
unnamed: U18.8, U21.2
unnamed: U18.11, U21.6
unnamed: U19.13, U23.6
unnamed: U19.14, U20.9
unnamed: U20.7, U21.9
unnamed: U22.1, U23.1
unnamed: U22.4, U23.2
unnamed: U22.10, U23.9
unnamed: U22.13, U23.10
unnamed: U23.3, U23.4
unnamed: U23.5, U23.8
unnamed: U24.3, U25.3, U32.12
unnamed: U24.4, U26.4
unnamed: U24.5, U28.1
unnamed: U24.6, U26.7
unnamed: U24.7, U28.3
unnamed: U24.9, U28.5
unnamed: U24.10, U26.12
unnamed: U24.11, U28.9
unnamed: U24.12, U26.9
unnamed: U25.4, U27.9
unnamed: U25.5, U29.5
unnamed: U25.6, U27.12
unnamed: U25.7, U29.3
unnamed: U25.9, U29.1
unnamed: U25.10, U27.7
unnamed: U25.11, U29.13
unnamed: U25.12, U27.4
unnamed: U31.3, U32.13
unnamed: U33.3, U34.3
unnamed: U33.6, U34.4
unnamed: U33.10, U34.6
unnamed: U33.13, U34.5
unnamed: U37.1, U39.3
unnamed: U37.10, U38.3, U45.22
unnamed: U37.6, U37.14, U38.2, U45.23
unnamed: U38.4, U43.3, U43.8
unnamed: U38.5, U42.3, U42.8
unnamed: U38.6, U41.3, U41.8
unnamed: U38.7, U40.3, U40.8
unnamed: U40.1, U41.1, U42.1, U43.1, U45.11
unnamed: U40.2, U41.2, U42.2, U43.2, U45.13
unnamed: U40.4, U41.4, U42.4, U43.4, U45.14
unnamed: U40.5, U41.5, U42.5, U43.5, U45.17
unnamed: U40.6, U41.6, U42.6, U43.6, U45.15
unnamed: U40.7, U41.7, U42.7, U43.7, U45.16
unnamed: U40.9, U41.9, U42.9, U43.9, U45.10
unnamed: U40.10, U41.10, U42.10, U43.10, U45.9
unnamed: U44.2, U45.8
unnamed: U44.5, U45.7
unnamed: U44.6, U45.6
unnamed: U44.9, U45.5
unnamed: U44.11, U46.3
unnamed: U44.12, U45.4
unnamed: U44.15, U45.3
unnamed: U44.16, U45.2
unnamed: U44.19, U45.1
unnamed: U48.1, U51.3
unnamed: U50.10, U51.5
unnamed: U51.1, U51.2, U51.6
VCC: C1.1, C10.1, C11.1, C12.1, C13.1, C14.1, C15.1, C16.1, C17.1, C18.1, C19.1, C20.1, C21.1, C22.1, C23.1, C24.1, J1.1, R1.1, R3.1, R4.1, R5.1, R6.1, R63.1, R64.1, R65.1, R67.1, R68.1, R69.1, R70.1, R71.1, SW7.3, SW8.2, U1.4, U1.8, U2.4, U2.8, U3.8, U4.14, U5.14, U6.14, U7.1, U7.20, U8.16, U9.16, U10.1, U10.19, U10.20, U11.16, U12.16, U13.1, U13.20, U14.16, U15.16, U16.14, U17.1, U17.20, U18.14, U19.16, U20.16, U21.16, U22.14, U23.14, U24.16, U25.16, U26.16, U27.16, U28.14, U29.14, U30.1, U30.20, U31.14, U32.16, U33.16, U34.16, U35.16, U36.20, U37.2, U37.3, U37.4, U37.5, U37.7, U37.8, U37.9, U37.12, U37.16, U38.16, U39.8, U44.20, U45.21, U45.24, U46.14, U47.21, U47.24, U48.7, U48.9, U48.10, U48.16, U49.14, U50.6, U50.16, U51.14, U52.1, U52.21, U52.24, U53.14
