dev1adesh/8-bitComputer/(notices)

Notices in the files:
8bit-computer.kicad_pcb:
©2018 Ben Eater — Rev A
